Kruemelbahn/Nebenuhr-Statusanzeige/LCDPanel.ino

//=== LCDPanel for Nebenuhr-Statusanzeige ===
#include <Wire.h>
#include <LCDPanel.h>

//=== declaration of var's =======================================
LCDPanel lcd = LCDPanel();

uint8_t ui8_LCDPresent = 0;  // ui8_LCDPresent: 1 if I2C-LCD-Panel is found

/* mode:
  0   after init "LN-FastClock" is displayed
  1   "Status?" is displayed
  2   "Inbetriebnahme?" is displayed
  7   "FastClock" is displayed
 
 10   view current FastClock state
 11   view current FastClock display state

 20   (edit) mode for CV1
 21   (edit) mode for CV2
 22   (edit) mode for CV3
 23   (edit) mode for CV4
 24   (edit) mode for CV5
 25   (edit) mode for CV6
 26   (edit) mode for CV7
 27   (edit) mode for CV8
 28   (edit) mode for CV9
 29   (edit) mode for CV10
 30   (edit) mode for CV11
 31   (edit) mode for CV12
 
 50   Test: Farbe rot
 51   Test: Farbe grün
 52   Test: Farbe blau
 53   Test: Farbe weiß
 54   Test: Farbe gelb

200   confirm display CV's
205   confirm display Farbentest
210   confirm display I2C-Scan
211   I2C-Scan

220   display IP-Address
221   display MAC-Address

*/
uint8_t ui8_LCDPanelMode = 0;  // ui8_LCDPanelMode for paneloperation

uint8_t ui8_ButtonMirror = 0;
static const uint8_t MAX_MODE = 19 + GetCVCount();

uint16_t ui16_EditValue = 0;
boolean b_Edit = false;

boolean b_IBN = false;

uint8_t ui8_CursorX = 0;

//----------------------------------------------------------------
uint16_t ui16_previCount = 0;
uint8_t ui8_prevRate = 0;
uint8_t ui8_prevSync = 0;
uint8_t ui8_prevFCHour = 0;
uint8_t ui8_prevFCMinute = 0;
boolean b_prevGetClockState = false;
boolean b_prevIsFastClockStarted = false;
boolean b_prevIsRunning = false;
boolean b_prevLnOk = false;
//=== functions ==================================================
boolean IBNbyDisplayPanel() { return b_IBN; }
uint8_t DisplayPanelMode() { return ui8_LCDPanelMode; }

void CheckAndInitLCDPanel()
{
  boolean b_LCDPanelDetected(lcd.detect_i2c(MCP23017_ADDRESS) == 0);
  if(!b_LCDPanelDetected && ui8_LCDPresent)
    // LCD was present is now absent:
    b_IBN = false;
    
  else if (b_LCDPanelDetected && !ui8_LCDPresent)
  {
    // LCD (newly) found:
    // set up the LCD's number of columns and rows: 
    lcd.begin(16, 2);

#if defined DEBUG
    Serial.println(F("LCD-Panel found..."));
    Serial.print(F("..."));
    Serial.println(GetSwTitle());
#endif

    if(AlreadyCVInitialized())
      OutTextTitle();

    ui8_LCDPanelMode = ui8_ButtonMirror = 0;
		ui16_EditValue = 0;
    b_Edit = b_IBN = false;

  } // else if (b_LCDPanelDetected && !ui8_LCDPresent)
  ui8_LCDPresent = (b_LCDPanelDetected ? 1 : 0);
}

void SetLCDPanelModeStatus()
{
  lcd.clear();
  lcd.setCursor(0, 0);  // set the cursor to column x, line y
  lcd.print(F("Status?"));
  ui8_LCDPanelMode = 1;
}

void SetLCDPanelModeIBN()
{
  lcd.clear();
  lcd.setCursor(0, 0);  // set the cursor to column x, line y
  lcd.print(F("Inbetriebnahme?"));
  ui8_LCDPanelMode = 2;
}

void SetLCDPanelModeCV()
{
  lcd.clear();
  lcd.setCursor(0, 0);  // set the cursor to column x, line y
  lcd.print(F("CV?"));
  ui8_LCDPanelMode = 200;
}

void SetLCDPanelModeTestColor()
{
  lcd.clear();
  lcd.setCursor(0, 0);  // set the cursor to column x, line y
  lcd.print(F("Farbentest?"));
  ui8_LCDPanelMode = 205;
}

void SetLCDPanelModeScan()
{
  lcd.clear();
  lcd.setCursor(0, 0);  // set the cursor to column x, line y
  lcd.print(F("I2C-Scan?"));
  ui8_LCDPanelMode = 210;
}

#if defined ETHERNET_BOARD
void SetLCDPanelModeIpAdr()
{
  lcd.clear();
  lcd.setCursor(0, 0);  // set the cursor to column x, line y
  lcd.print(F("IP-Adresse"));
  lcd.setCursor(0, 1);  // set the cursor to column x, line y
  lcd.print(Ethernet.localIP());
  ui8_LCDPanelMode = 220;
}

void SetLCDPanelModeMacAdr()
{
  lcd.clear();
  lcd.setCursor(0, 0);  // set the cursor to column x, line y
  lcd.print(F("MAC-Adresse"));
  lcd.setCursor(0, 1);  // set the cursor to column x, line y
  uint8_t *mac(GetMACAddress());
  for(uint8_t i = 0; i < 6; i++)
  {
    hexout(lcd, (uint8_t)(mac[i]), 2);
    if((i == 1) || (i == 3))
      lcd.print('.');
  }

  ui8_LCDPanelMode = 221;
}
#endif

void InitScan()
{
   lcd.setCursor(8, 0);  // set the cursor to column x, line y
   lcd.print(' ');       // clear '?'
   ui16_EditValue = -1;
   NextScan();
}

void NextScan()
{
   ++ui16_EditValue;
   lcd.setCursor(0, 1);  // set the cursor to column x, line y
   
   if(ui16_EditValue > 127)
   {
     OutTextFertig();
     return;
   }

   uint8_t error(0);
   do
   {
     Wire.beginTransmission((uint8_t)(ui16_EditValue));
     error = Wire.endTransmission();

     if ((error == 0) || (error==4))
     {
       lcd.print(F("0x"));
       hexout(lcd, (uint8_t)(ui16_EditValue), 2);
       lcd.print((error == 4) ? '?' : ' ');
       break;
     }

     ++ui16_EditValue;
     if(ui16_EditValue > 127)
     { // done:
       OutTextFertig();
       break;
     }
   } while (true);
}

void OutTextFertig() { lcd.print(F("fertig")); }

void OutTextTitle()
{
  lcd.clear();
  lcd.setCursor(0, 0);  // set the cursor to column x, line y
  lcd.print(GetSwTitle()); 
    
  lcd.setCursor(0, 1);
  lcd.print(F("Version "));
  lcd.print(GetCV(VERSION_NUMBER));
#if defined DEBUG
  lcd.print(F(" Deb"));
#endif
#if defined TELEGRAM_FROM_SERIAL
  lcd.print(F("Sim"));
#endif
}

void OutTextClockStatus(boolean bForce)
{
	uint16_t ui16_curriCount(0);
	uint8_t ui8_currRate(0);
	uint8_t ui8_currSync(0);
  uint8_t ui8_currFCHour(0);
  uint8_t ui8_currFCMinute(0);
  GetFastClock(&ui8_currFCHour, &ui8_currFCMinute);
	const boolean b_currGetClockState(GetClockState(&ui16_curriCount, &ui8_currRate, &ui8_currSync));

  boolean bUpdate(bForce);
  if (ui16_curriCount != ui16_previCount)
    bUpdate = true;
  if (ui8_currRate != ui8_prevRate)
    bUpdate = true;
  if (ui8_currSync != ui8_prevSync)
    bUpdate = true;
  if (ui8_currFCHour != ui8_prevFCHour)
    bUpdate = true;
  if (ui8_currFCMinute != ui8_prevFCMinute)
    bUpdate = true;
  if (b_prevGetClockState != b_currGetClockState)
    bUpdate = true;
  if(!bUpdate)
    return;

  ui16_previCount = ui16_curriCount;
  ui8_prevRate = ui8_currRate;
  ui8_prevSync = ui8_currSync;
  ui8_prevFCHour = ui8_currFCHour;
  ui8_prevFCMinute = ui8_currFCMinute;
  b_prevGetClockState = b_currGetClockState;

  lcd.setCursor(0, 1);  // set the cursor to column x, line y

  if (!b_currGetClockState)
		lcd.print(F("---"));
	else
	{
		decout(lcd, ui16_curriCount, 4);
		lcd.print(F("-"));
    lcd.print(F("1:"));
    decout(lcd, ui8_currRate, 2); // Rate: 0 = Freeze clock, 1 = normal, 10 = 10:1 etc. max is 0x7F
		lcd.print('-');
		lcd.print(ui8_currSync? '1' : '0');
		lcd.print('-');
		lcd.print((ui8_currFCMinute % 2) ? "O" : "E");
	} // else if (!bGetClockState)
}

void OutTextDisplayStatus(boolean bForce)
{
  uint8_t ui8_currFCHour(0);
  uint8_t ui8_currFCMinute(0);
  const boolean b_currIsFastClockStarted(GetFastClock(&ui8_currFCHour, &ui8_currFCMinute));  // set if at least one telegramm received
  const boolean b_currIsRunning(isFastClockRunning()); // set if clockrate is not zero
  const uint8_t ui8_currRate(GetClockRate());
  const boolean b_currLnOk(IsLnOk());

  boolean bUpdate(bForce);
  if (ui8_currRate != ui8_prevRate)
    bUpdate = true;
  if (ui8_currFCHour != ui8_prevFCHour)
    bUpdate = true;
  if (ui8_currFCMinute != ui8_prevFCMinute)
    bUpdate = true;
  if (b_prevIsFastClockStarted != b_currIsFastClockStarted)
    bUpdate = true;
  if (b_prevIsRunning != b_currIsRunning)
    bUpdate = true;
  if (b_prevLnOk != b_currLnOk)
    bUpdate = true;
  if(!bUpdate)
    return;

  ui8_prevRate = ui8_currRate;
  ui8_prevFCHour = ui8_currFCHour;
  ui8_prevFCMinute = ui8_currFCMinute;
  b_prevIsFastClockStarted = b_currIsFastClockStarted;
  b_prevIsRunning = b_currIsRunning;
  b_prevLnOk = b_currLnOk;

  const boolean bRed(!b_currIsRunning);
  const boolean bGreen(b_currIsRunning && (ui8_currRate > 1));
  const boolean bBlue(b_currIsRunning && (ui8_currRate == 1));

  lcd.setCursor(0, 1);  // set the cursor to column x, line y

  if(bRed)
		lcd.print(F("R"));
  else
		lcd.print(F("-"));
  if(bGreen)
		lcd.print(F("G"));
  else
		lcd.print(F("-"));
  if(bBlue)
		lcd.print(F("B"));
  else
		lcd.print(F("-"));

  lcd.setCursor(4, 1);  // set the cursor to column x, line y
  if(b_currIsRunning)
		lcd.print(F("Run"));
  else
		lcd.print(F("Stp"));

  lcd.setCursor(8, 1);  // set the cursor to column x, line y
  if(b_currIsFastClockStarted)
		lcd.print(F("T"));
  else
		lcd.print(F("-"));

  lcd.setCursor(10, 1);  // set the cursor to column x, line y
	lcd.print(F("1:"));
  decout(lcd, ui8_currRate, 2);  // Rate: 0 = Freeze clock, 1 = normal, 10 = 10:1 etc. max is 0x7F

  lcd.setCursor(15, 1);  // set the cursor to column x, line y
  if(b_currLnOk)
		lcd.print(F("+"));
  else
		lcd.print(F("-"));
}

void OutTextFastClockTime(boolean bForce)
{
  uint8_t ui8_currFCHour(0);
  uint8_t ui8_currFCMinute(0);
  const boolean bGetFastClock(GetFastClock(&ui8_currFCHour, &ui8_currFCMinute));

  boolean bUpdate(bForce);
  if (ui8_currFCHour != ui8_prevFCHour)
    bUpdate = true;
  if (ui8_currFCMinute != ui8_prevFCMinute)
    bUpdate = true;
  if(!bUpdate)
    return;

  ui8_prevFCHour = ui8_currFCHour;
  ui8_prevFCMinute = ui8_currFCMinute;

  lcd.setCursor(0, 1);  // set the cursor to column x, line y
  if (bGetFastClock)
  {
    if (ui8_currFCHour < 23)
      decout(lcd, ui8_currFCHour, 2);
    else
      lcd.print(F("??"));
    lcd.print(':');
    if(ui8_currFCMinute < 60) 
      decout(lcd, ui8_currFCMinute, 2);
    else 
      lcd.print(F("??"));
  } // if (bGetFastClock)
  else
    lcd.print(F("--:--"));
}

void DisplayCV(uint16_t ui16_Value)
{
  lcd.noCursor();
  lcd.clear();
  lcd.setCursor(0, 0);  // set the cursor to column x, line y
  lcd.print(F("CV"));
  lcd.setCursor(3, 0);
  uint8_t ui8CvNr(ui8_LCDPanelMode - 19);
  if (ui8CvNr < 10)
    lcd.print(' ');
  lcd.print(ui8CvNr);
  --ui8CvNr;

  // show shortname:
  lcd.setCursor(6, 0);
  lcd.print(GetCVName(ui8CvNr));

  lcd.setCursor(0, 1);
  if (b_Edit)
    lcd.print('>');
  if (IsCVBinary(ui8CvNr))
    binout(lcd, ui16_Value);
  else
    decout(lcd, ui16_Value, GetCountOfDigits(ui8CvNr));
  if (!b_Edit && !CanEditCV(ui8CvNr))
  {
    lcd.setCursor(14, 1);
    lcd.print(F("ro"));
  }
  if (b_Edit && CanEditCV(ui8CvNr))
  {
    lcd.setCursor(ui8_CursorX, 1);
    lcd.cursor();
  }
}

void DisplayColorText()
{
  lcd.setCursor(0, 1);  // set the cursor to column x, line y
  if (ui8_LCDPanelMode == MIN_COLOR)
  { // rot
    lcd.print(F("rot   "));
  } // if (ui8_LCDPanelMode == MIN_COLOR)
  else if (ui8_LCDPanelMode == (MIN_COLOR + 1))
  { // grün
    lcd.print(F("gr"));
    lcd.print(char(0xF5));  // ü
    lcd.print(F("n  "));
  } // else if (ui8_LCDPanelMode == (MIN_COLOR + 1))
  else if (ui8_LCDPanelMode == (MIN_COLOR + 2))
  { // blau
    lcd.print(F("blau  "));
  } // else if (ui8_LCDPanelMode == (MIN_COLOR + 2))
  else if (ui8_LCDPanelMode == (MIN_COLOR + 3))
  { // blau
    lcd.print(F("wei"));
    lcd.print(char(0xE2));  // ß
    lcd.print(F("  "));
  } // else if (ui8_LCDPanelMode == (MIN_COLOR + 3))
  else if (ui8_LCDPanelMode == (MIN_COLOR + 4))
  { // gelb
    lcd.print(F("gelb  "));
  } // else if (ui8_LCDPanelMode == (MIN_COLOR + 4))
}

uint8_t GetCountOfDigits(uint8_t ui8CvNr)
{
  uint16_t ui16MaxCvValue(GetCVMaxValue(ui8CvNr));
  if (ui16MaxCvValue > 9999)
    return 5;
  if (ui16MaxCvValue > 999)
    return 4;
  if (ui16MaxCvValue > 99)
    return 3;
  if (ui16MaxCvValue > 9)
    return 2;
  return 1;
}

uint16_t GetFactor(uint8_t ui8CvNr)
{
  uint16_t ui16_faktor(0);
  uint8_t ui8_Position(GetCountOfDigits(ui8CvNr));
  switch (ui8_Position - ui8_CursorX)
  {
    case 0: ui16_faktor = 1; break;
    case 1: ui16_faktor = 10; break;
    case 2: ui16_faktor = 100; break;
    case 3: ui16_faktor = 1000; break;
    case 4: ui16_faktor = 10000; break;
  } // switch (ui8_Position - ui8_CursorX)
  return ui16_faktor;
}

void HandleLCDPanel()
{
  CheckAndInitLCDPanel();

  if (!ui8_LCDPresent)
  {
    b_IBN = false;
    return;
  } // if (!ui8_LCDPresent)

  uint8_t ui8_bs(1);
  if(lcd.readButtonA5() == BUTTON_A5)
    ui8_bs = 0;
  lcd.setBacklight(ui8_bs);

  uint8_t ui8_buttons(lcd.readButtons());  // reads only 5 buttons (A0...A4)
  if(!ui8_buttons && (ui8_ButtonMirror != ui8_buttons))
  {
    ui8_ButtonMirror = 0;
    return;
  } // if(!ui8_buttons && (ui8_ButtonMirror != ui8_buttons))

  if(ui8_buttons && (ui8_ButtonMirror != ui8_buttons))
  {
    ui8_ButtonMirror = ui8_buttons;
    if(ui8_LCDPanelMode == 0)
    {
      if (ui8_buttons & BUTTON_DOWN)
      { // switch to Status?
        SetLCDPanelModeStatus();  // mode = 1
      }
      return;
    } // if(ui8_LCDPanelMode == 0)
    //------------------------------------
    if(ui8_LCDPanelMode == 1)
    {
      // actual ui8_LCDPanelMode = "Status?"
      if (ui8_buttons & BUTTON_UP)
      { // switch to Title
        OutTextTitle();
        ui8_LCDPanelMode = 0;
        return;
      }
      if (ui8_buttons & BUTTON_DOWN)
      { // switch to IBN
        SetLCDPanelModeIBN(); // mode = 2
        return;
      }
      if (ui8_buttons & BUTTON_RIGHT)
      { // switch to display current clock state
				lcd.clear();
				lcd.setCursor(0, 0);  // set the cursor to column x, line y
				lcd.print(F("Status"));
        OutTextClockStatus(true);
        ui8_LCDPanelMode = 10;
        return;
      }
    } // if(ui8_LCDPanelMode == 1)
    //------------------------------------
    if(ui8_LCDPanelMode == 2)
    {
      // actual ui8_LCDPanelMode = "IBN?"
      if (ui8_buttons & BUTTON_UP)
      { // switch to Status
        SetLCDPanelModeStatus();  // mode = 1
      }
      else if (ui8_buttons & BUTTON_RIGHT)
      { // switch to ask CV / TestModus / I²C-Scan
        SetLCDPanelModeCV();
      }
      else if (ui8_buttons & BUTTON_DOWN)
      { // switch to FastClock
        ui8_LCDPanelMode = 7;
        lcd.clear();
        lcd.setCursor(0, 0);  // set the cursor to column x, line y
        lcd.print(F("FastClock"));
        OutTextFastClockTime(true);
      }
      return;
    } // if(ui8_LCDPanelMode == 2)
    //------------------------------------
    if(ui8_LCDPanelMode == 7)
    {
      // actual ui8_LCDPanelMode = "FastClock"
      if (ui8_buttons & BUTTON_UP)
      { // switch to IBN
        SetLCDPanelModeIBN(); // mode = 2
        return;
      } // if (ui8_buttons & BUTTON_UP)
      if (ui8_buttons & BUTTON_SELECT)
        PollFastClock();
    } // if(ui8_LCDPanelMode == 7)
    //------------------------------------
    if(ui8_LCDPanelMode == 10)
    {
      // actual ui8_LCDPanelMode = view current clock state
      if (ui8_buttons & BUTTON_LEFT)
      { // switch to display "Status?"
        SetLCDPanelModeStatus();  // mode = 1
        return;
      }
      if (ui8_buttons & BUTTON_RIGHT)
      { // switch to display current clock state
				lcd.clear();
				lcd.setCursor(0, 0);  // set the cursor to column x, line y
				lcd.print(F("Display-Status"));
        OutTextDisplayStatus(true);
        ui8_LCDPanelMode = 11;
        return;
      }
    } // if(ui8_LCDPanelMode == 10)
    //------------------------------------
    if(ui8_LCDPanelMode == 11)
    {
      // actual ui8_LCDPanelMode = view current clock state
      if (ui8_buttons & BUTTON_LEFT)
      { // switch to display current clock state
				lcd.clear();
				lcd.setCursor(0, 0);  // set the cursor to column x, line y
				lcd.print(F("Status"));
        OutTextClockStatus(true);
        ui8_LCDPanelMode = 10;
        return;
      }
    } // if(ui8_LCDPanelMode == 11)
    //------------------------------------
    if ((ui8_LCDPanelMode >= 20) && (ui8_LCDPanelMode <= MAX_MODE))
    {
      uint8_t ui8CurrentCvNr(ui8_LCDPanelMode - 20);
      // actual ui8_LCDPanelMode = view CV
      if (ui8_buttons & BUTTON_SELECT)
      { // save value for current CV
        if (b_Edit)
        {
          // save current value
          boolean b_OK(CheckAndWriteCVtoEEPROM(ui8CurrentCvNr, ui16_EditValue));
          DisplayCV(GetCV(ui8CurrentCvNr));
          lcd.setCursor(10, 1);  // set the cursor to column x, line y
          lcd.print(b_OK ? F("stored") : F("failed"));
          lcd.setCursor(ui8_CursorX, 1);
        }
        return;
      }
      if (ui8_buttons & BUTTON_LEFT)
      { // switch to display current CV's
        if (b_Edit)
        {
          // leave edit-mode (without save)
          b_Edit = false;
          DisplayCV(GetCV(ui8CurrentCvNr));
          return;
        }
        SetLCDPanelModeCV();
        b_IBN = false;
        return;
      }
      if (ui8_buttons & BUTTON_RIGHT)
      { // switch to edit current CV's
        if (!b_Edit && CanEditCV(ui8CurrentCvNr))
        {
          // enter edit-mode
          ui16_EditValue = GetCV(ui8CurrentCvNr);
          b_Edit = true;
          ui8_CursorX = 0;
          DisplayCV(ui16_EditValue);
        }
        if (b_Edit)
        { // move cursor only in one direction
          ++ui8_CursorX;

          // rollover:
          if (IsCVBinary(ui8CurrentCvNr))
          {
            if (ui8_CursorX == 9)
              ui8_CursorX = 1;
          }
          else
          {
            if (ui8_CursorX == (GetCountOfDigits(ui8CurrentCvNr) + 1))
              ui8_CursorX = 1;
          }

          lcd.setCursor(ui8_CursorX, 1);
          lcd.cursor();
        }
        return;
      }
      if (ui8_buttons & BUTTON_UP)
      {
        if (b_Edit)
        { // Wert vergrößern:
          uint16_t ui16_CurrentValue(ui16_EditValue);
          if (IsCVUI8(ui8CurrentCvNr) || IsCVUI16(ui8CurrentCvNr))
          {
            ui16_EditValue += GetFactor(ui8CurrentCvNr);
            if (ui16_EditValue < ui16_CurrentValue)
              ui16_EditValue = ui16_CurrentValue;  // Überlauf
          }

          if (IsCVBinary(ui8CurrentCvNr))
            ui16_EditValue |= (1 << (8 - ui8_CursorX));

          if (ui16_EditValue > GetCVMaxValue(ui8CurrentCvNr))
            ui16_EditValue = ui16_CurrentValue;  // Überlauf

          DisplayCV(ui16_EditValue);
          return;
        }
        // switch to next CV
        ++ui8_LCDPanelMode;
        if (ui8_LCDPanelMode >= MAX_MODE)
          ui8_LCDPanelMode = MAX_MODE;
        DisplayCV(GetCV(ui8_LCDPanelMode - 20)); // ui8_LCDPanelMode has changed :-)
        return;
      }
      if (ui8_buttons & BUTTON_DOWN)
      {
        if (b_Edit)
        { // Wert verkleinern:
          uint16_t ui16_CurrentValue(ui16_EditValue);
          if (IsCVUI8(ui8CurrentCvNr) || IsCVUI16(ui8CurrentCvNr))
          {
            ui16_EditValue -= GetFactor(ui8CurrentCvNr);
            if (ui16_EditValue > ui16_CurrentValue)
              ui16_EditValue = ui16_CurrentValue; // Unterlauf
          }

          if (IsCVBinary(ui8CurrentCvNr))
            ui16_EditValue &= ~(1 << (8 - ui8_CursorX));

          if (ui16_EditValue < GetCVMinValue(ui8CurrentCvNr))
            ui16_EditValue = ui16_CurrentValue; // Unterlauf

          if (ui16_EditValue == UINT16_MAX) // 0 -> 255/65535
            ui16_EditValue = ui16_CurrentValue; // Unterlauf

          DisplayCV(ui16_EditValue);
          return;
        }
        // switch to previous CV
        --ui8_LCDPanelMode;
        if (ui8_LCDPanelMode < 20)
          ui8_LCDPanelMode = 20;
        DisplayCV(GetCV(ui8_LCDPanelMode - 20)); // ui8_LCDPanelMode has changed :-)
        return;
      }
    } // if((ui8_LCDPanelMode >= 20) && (ui8_LCDPanelMode <= MAX_MODE))
    //------------------------------------
    if ((ui8_LCDPanelMode >= MIN_COLOR) && (ui8_LCDPanelMode <= MAX_COLOR))
    {
      // actual ui8_LCDPanelMode = test colors
      if (ui8_buttons & BUTTON_LEFT)
      { // switch to display current CV's
        SetLCDPanelModeTestColor();
        b_IBN = false;
        return;
      } // if (ui8_buttons & BUTTON_LEFT)
      if (ui8_buttons & BUTTON_UP)
      {
        // switch to next color
        ++ui8_LCDPanelMode;
        if (ui8_LCDPanelMode >= MAX_COLOR)
          ui8_LCDPanelMode = MAX_COLOR;
        DisplayColorText();
        return;
      } // if (ui8_buttons & BUTTON_UP)
      if (ui8_buttons & BUTTON_DOWN)
      {
        // switch to previous color
        --ui8_LCDPanelMode;
        if (ui8_LCDPanelMode < MIN_COLOR)
          ui8_LCDPanelMode = MIN_COLOR;
        DisplayColorText();
        return;
      } // if (ui8_buttons & BUTTON_DOWN)
    } // if ((ui8_LCDPanelMode >= MIN_COLOR) && (ui8_LCDPanelMode <= MAX_COLOR))
    //------------------------------------
    if(ui8_LCDPanelMode == 200)
    {
      // actual ui8_LCDPanelMode = "CV?"
      if (ui8_buttons & BUTTON_DOWN)
      { // switch to "Farbentest?"
        SetLCDPanelModeTestColor();
      }
      else if (ui8_buttons & BUTTON_LEFT)
      { // switch to "IBN?"
        SetLCDPanelModeIBN();
      }
      else if (ui8_buttons & BUTTON_RIGHT)
      { // switch to display current CV's
        ui8_LCDPanelMode = 20;
        DisplayCV(GetCV(ID_DEVICE));
        b_IBN = true;
      }
      return;
    } // if(ui8_LCDPanelMode == 200)
    //------------------------------------
    if(ui8_LCDPanelMode == 205)
    {
      // actual ui8_LCDPanelMode = "Farbentest?"
      if (ui8_buttons & BUTTON_DOWN)
      { // switch to I²C-Scan
        SetLCDPanelModeScan();
      } // if (ui8_buttons & BUTTON_DOWN)
      else if (ui8_buttons & BUTTON_LEFT)
      { // switch to "IBN?"
        SetLCDPanelModeIBN();
      } // else if (ui8_buttons & BUTTON_LEFT)
      else if (ui8_buttons & BUTTON_UP)
      { // switch to "CV?"
        SetLCDPanelModeCV();
      } // else if (ui8_buttons & BUTTON_UP)
      else if (ui8_buttons & BUTTON_RIGHT)
      { // switch to display current colors
        ui8_LCDPanelMode = MIN_COLOR;
        lcd.clear();
        lcd.setCursor(0, 0);  // set the cursor to column x, line y
        lcd.print(F("Farbentest"));
        DisplayColorText();
        b_IBN = true;
      } // else if (ui8_buttons & BUTTON_RIGHT)
      return;
    } // if(ui8_LCDPanelMode == 205)
    //------------------------------------
    if(ui8_LCDPanelMode == 210)
    {
      // actual ui8_LCDPanelMode = "I²C-Scan?"
      if (ui8_buttons & BUTTON_UP)
      { // switch to "Farbentest?"
        SetLCDPanelModeTestColor();
      }
      else if (ui8_buttons & BUTTON_LEFT)
      { // switch to "Inbetriebnahme?"
        SetLCDPanelModeIBN();
      }
      else if (ui8_buttons & BUTTON_RIGHT)
      { // switch to display I²C-Addresses
        ui8_LCDPanelMode = 211;
        InitScan();
      }
#if defined ETHERNET_BOARD
      else if (ui8_buttons & BUTTON_DOWN)
      { // switch to display IP-Address
        SetLCDPanelModeIpAdr();
      }
#endif
      return;
    } // if(ui8_LCDPanelMode == 210)
    //------------------------------------
    if(ui8_LCDPanelMode == 211)
    {
      // actual ui8_LCDPanelMode = "I²C-Scan"
      if (ui8_buttons & BUTTON_LEFT)
      { // switch to "I²C-Scan?"
        SetLCDPanelModeScan();
        return;
      }
      if (ui8_buttons & BUTTON_DOWN)
      {
        NextScan();
        return;
      }
    } // if(ui8_LCDPanelMode == 211)
    //------------------------------------
#if defined ETHERNET_BOARD
    if(ui8_LCDPanelMode == 220)
    {
      // actual ui8_LCDPanelMode = "IP-Address"
      if (ui8_buttons & BUTTON_UP)
      { // switch to "I²C-Scan ?"
        SetLCDPanelModeScan();
      }
      else if (ui8_buttons & BUTTON_DOWN)
      { // switch to "MAC-Address"
        SetLCDPanelModeMacAdr();
      }
      return;
    } // if(ui8_LCDPanelMode == 220)
    if(ui8_LCDPanelMode == 221)
    {
      // actual ui8_LCDPanelMode = "MAC-Address"
      if (ui8_buttons & BUTTON_FCT_BACK)
      { // any key returns to "IP-Address"
        SetLCDPanelModeIpAdr();
      }
      return;
    } // if(ui8_LCDPanelMode == 221)
#endif
  } // if(ui8_buttons && (ui8_ButtonMirror != ui8_buttons))
  //========================================================================
  if(ui8_LCDPanelMode == 7)
    OutTextFastClockTime(false);
  //========================================================================
  if(ui8_LCDPanelMode == 10)
		OutTextClockStatus(false);
  //========================================================================
  if(ui8_LCDPanelMode == 11)
		OutTextDisplayStatus(false);
  //========================================================================
}
